bananaflux/OpenSourceSyringePump/README.md

# OpenSourceSyringePump

* Printed circuit board can be easily ordered from OSHPark: [Open Source Syringe Pump PCB](https://oshpark.com/shared_projects/VtseE2Ia)
