bananaflux/OpenSourceSyringePump/t_min and velocity formulas.pdf

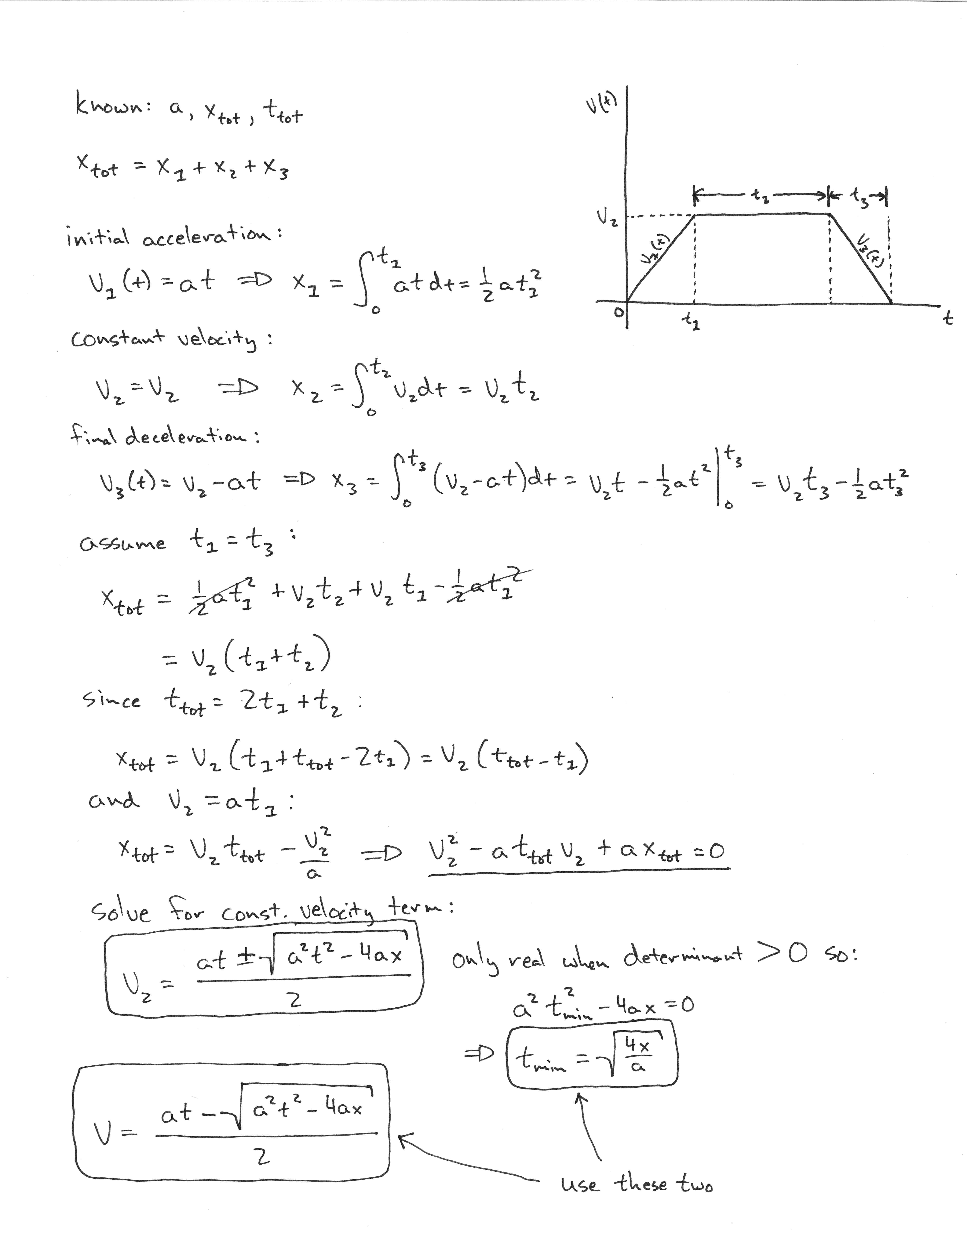
[picture p1: page 1]
