bananaflux/OpenSourceSyringePump/Syringe_Calibration_Water_Sucrose.xlsx

Sheet: 16% 60mL Syringe
Density = | 1.0472 | [g/mL]
60 mL Syringe
Steps | Mass [g] | ΔMass [g] | Vol [mL] | Vol/Step [mL/step]
0 | 0
400 | 0.7778 | 0.7778 | 0.7427425516 | 0.001856856379
800 | 1.5632 | 0.7854 | 0.75 | 0.001875
1200 | 2.3608 | 0.7976 | 0.7616501146 | 0.001904125286
1600 | 3.15 | 0.7892 | 0.7536287242 | 0.001884071811
2000 | 3.9555 | 0.8055 | 0.7691940413 | 0.001922985103
2400 | 4.74 | 0.7845 | 0.7491405653 | 0.001872851413
2800 | 5.551 | 0.811 | 0.7744461421 | 0.001936115355
3200 | 6.3425 | 0.7915 | 0.7558250573 | 0.001889562643
3600 | 7.119 | 0.7765 | 0.7415011459 | 0.001853752865
4000 | 7.9112 | 0.7922 | 0.7564935065 | 0.001891233766
4400 | 8.75 | 0.8388 | 0.8009931245 | 0.002002482811
4800 | 9.5191 | 0.7691 | 0.734434683 | 0.001836086707
5200 | 10.379 | 0.8599 | 0.8211420932 | 0.002052855233
5600 | 11.1247 | 0.7457 | 0.7120893812 | 0.001780223453
6000 | 11.96 | 0.8353 | 0.7976508785 | 0.001994127196
6400 | 12.7244 | 0.7644 | 0.7299465241 | 0.00182486631
6800 | 13.54 | 0.8156 | 0.7788388083 | 0.001947097021
7200 | 14.283 | 0.743 | 0.7095110772 | 0.001773777693
7600 | 15.045 | 0.762 | 0.7276546982 | 0.001819136746
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
