bananaflux/OpenSourceSyringePump/SyringeCalibrationExample.xlsx

Sheet: 30mL Syringe
Density = | 0.995868 | [g/mL]
30mL Syringe
Steps | Mass [g] | ΔMass [g] | Vol [mL] | Vol/Step [mL/step]
0 | 0
500 | 0.5925 | 0.5925 | 0.594958368 | 0.001189916736
1000 | 1.2101 | 0.6176 | 0.6201625115 | 0.001240325023
1500 | 1.8335 | 0.6234 | 0.6259865765 | 0.001251973153
2000 | 2.4469 | 0.6134 | 0.6159450851 | 0.00123189017
2500 | 3.0622 | 0.6153 | 0.6178529685 | 0.001235705937
3000 | 3.685 | 0.6228 | 0.625384087 | 0.001250768174
3500 | 4.2961 | 0.6111 | 0.6136355421 | 0.001227271084
4000 | 4.9138 | 0.6177 | 0.6202629264 | 0.001240525853
4500 | 5.5353 | 0.6215 | 0.6240786932 | 0.001248157386
5000 | 6.1469 | 0.6116 | 0.6141376166 | 0.001228275233
5500 | 6.7624 | 0.6155 | 0.6180537983 | 0.001236107597
6000 | 7.384 | 0.6216 | 0.6241791081 | 0.001248358216
6500 | 7.9928 | 0.6088 | 0.611325999 | 0.001222651998
7000 | 8.6107 | 0.6179 | 0.6204637562 | 0.001240927512
7500 | 9.2296 | 0.6189 | 0.6214679054 | 0.001242935811
8000 | 9.8421 | 0.6125 | 0.6150413509 | 0.001230082702
8500 | 10.4576 | 0.6155 | 0.6180537983 | 0.001236107597
9000 | 11.0804 | 0.6228 | 0.625384087 | 0.001250768174
9500 | 11.6888 | 0.6084 | 0.6109243394 | 0.001221848679
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
