bananaflux/OpenSourceSyringePump/Hardware/OpenSourceSyringePumpPCB.pdf

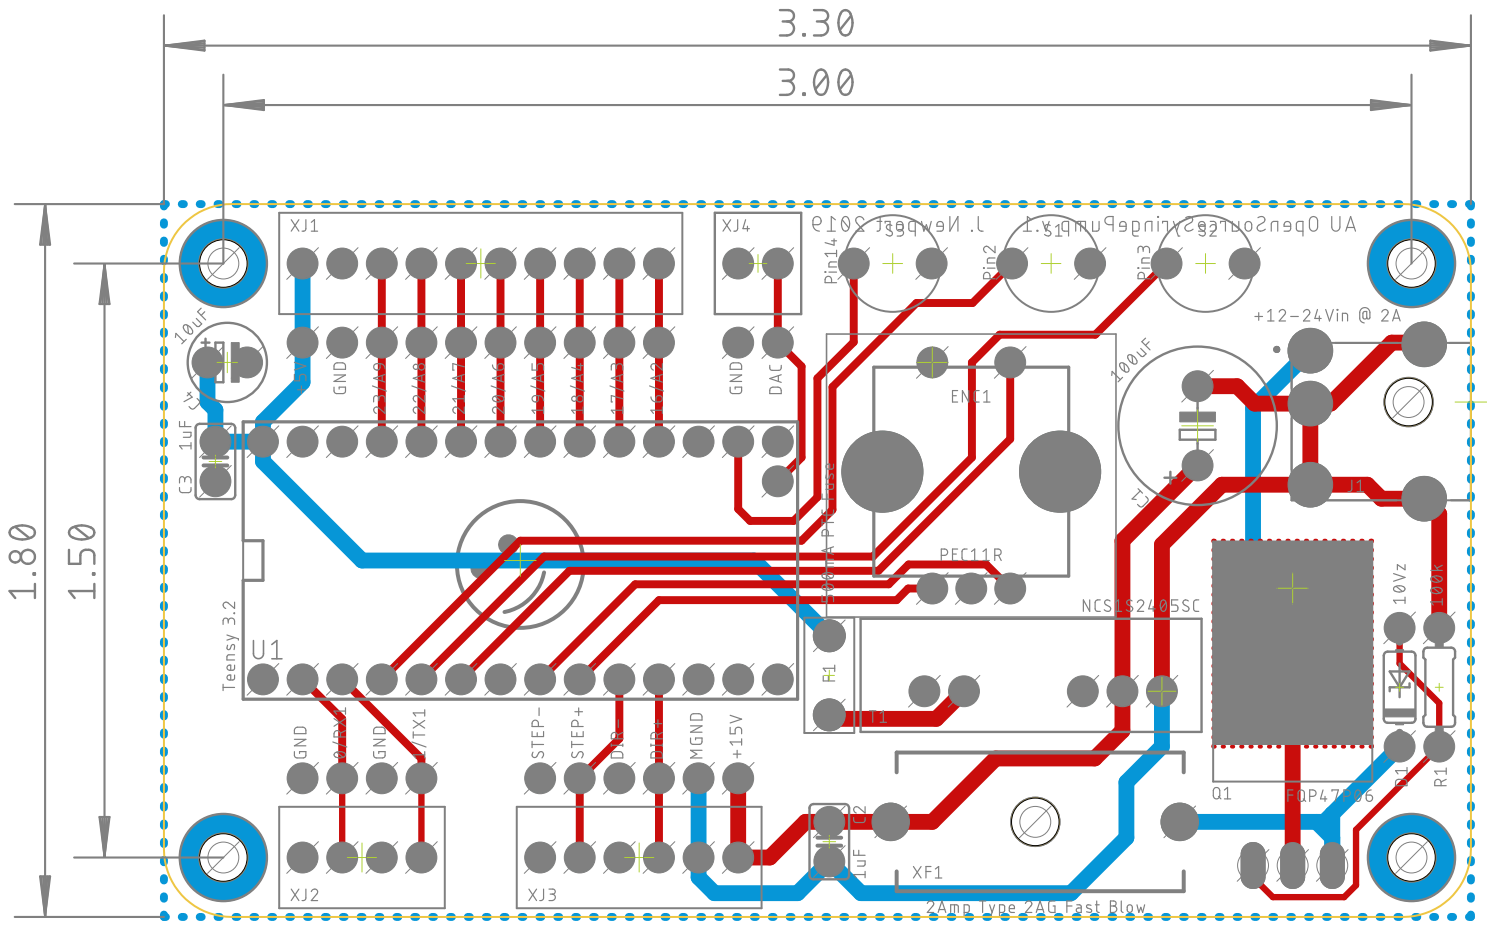
[picture p14: page 1]
