bananaflux/OpenSourceSyringePump/Hardware/OpenSourceSyringePumpSchematic.pdf

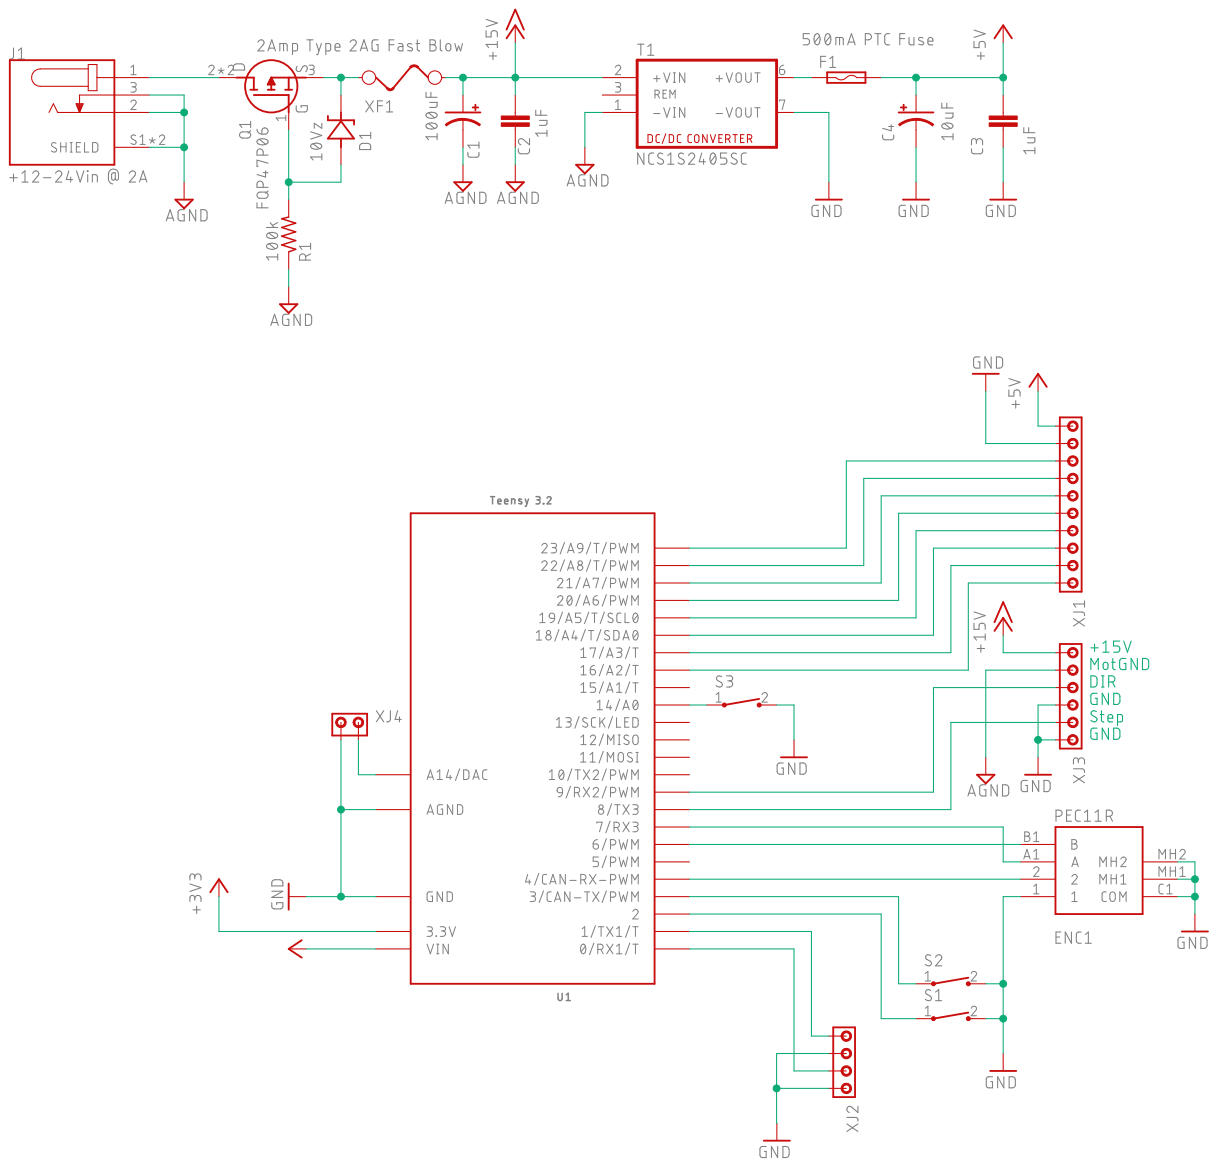
[picture p15: page 1]
