bananaflux/OpenSourceSyringePump/Hardware/OpenSourceSyringePump.brd

## EAGLE design Hardware/OpenSourceSyringePump.brd (2019-06-10)

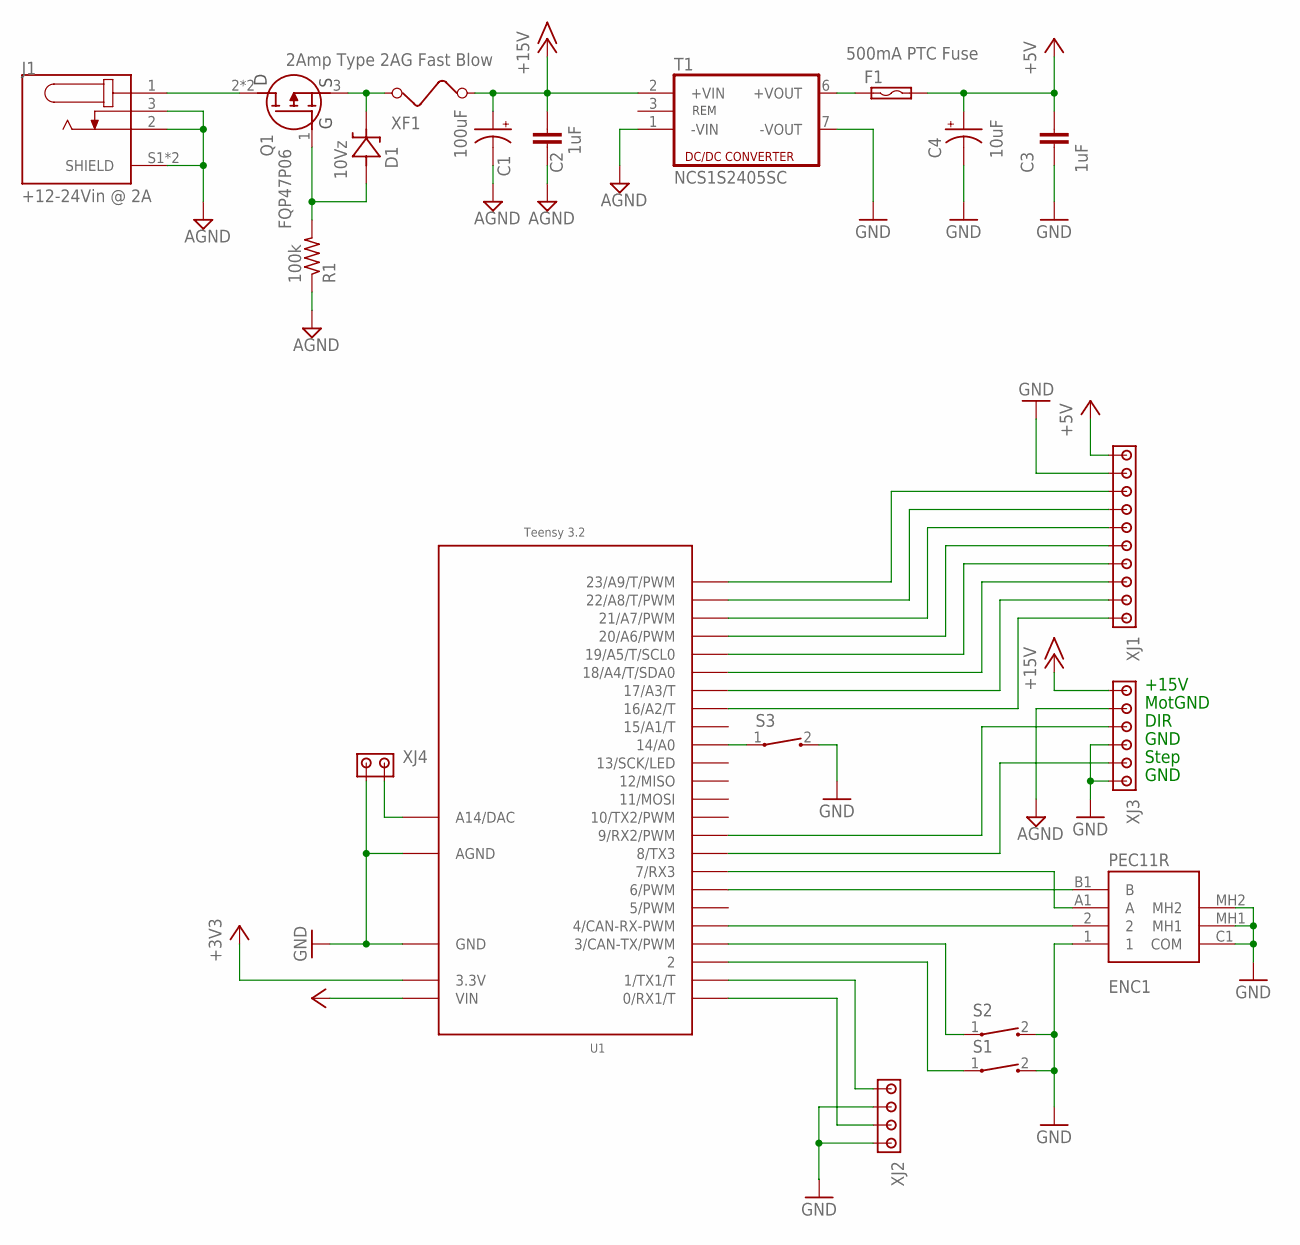
[picture p16: schematic OpenSourceSyringePump.sch]

Parts:
C1: 100uF; EEUFR1H101
C2, C3: 1uF; K105Z20Y5VF5TL2
C4: 10uF; TAP106K025SCS
D1: 10Vz; BZX79C10
ENC1: PEC11R; PEC11R4220FS0024
F1: 500mA PTC Fuse; BOURNS-MF-R025
J1: +12-24Vin @ 2A; CUI_PJ-079AH
Q1: FQP47P06
R1: 100k; 0204/7
S1, S2, S3: ALPS-SKRGAFD010
T1: NCS1S2405SC; MURATA-NCS1S2405SC
U1: Teensy 3.2; TEENSY_3.0-3.2&LC_OUTER_ROW
XF1: 2Amp Type 2AG Fast Blow; LITTLEFUSE-02540101Z
XJ1: TE-1-282834-0-DOUBLE
XJ2: TE-282834-4-DOUBLE
XJ3: TE-282834-6-DOUBLE
XJ4: TE-282834-2-DOUBLE

Connections:
+3V3: U1.3.3V
+5V: C3.1, C4.+, F1.2, U1.VIN, XJ1.1, XJ1.P$1 (1)
+15V: C1.+, C2.1, T1.2 (+VIN), XF1.1, XJ3.1, XJ3.P$1 (1)
GND: C3.2, C4.-, ENC1.1, ENC1.C1 (COM), ENC1.MH1, ENC1.MH2, S1.2, S2.2, S3.2, T1.7 (-VOUT), U1.AGND, U1.GND, XJ1.2, XJ1.P$2 (2), XJ2.2, XJ2.4, XJ2.P$2 (2), XJ2.P$4 (4), XJ3.4, XJ3.6, XJ3.P$4 (4), XJ3.P$6 (6), XJ4.1, XJ4.P$1 (1)
MGND: C1.-, C2.2, J1.2, J1.3, J1.S1 (SHIELD), J1.S2 (SHIELD), R1.1, T1.1 (-VIN), XJ3.2, XJ3.P$2 (2)
unnamed: J1.1, Q1.2 (D), Q1.MH (D)
unnamed: D1.A, Q1.1 (G), R1.2
unnamed: F1.1, T1.6 (+VOUT)
unnamed: D1.C, Q1.3 (S), XF1.2
unnamed: ENC1.B1 (B), U1.6 (6/PWM)
unnamed: ENC1.A1 (A), U1.7 (7/RX3)
unnamed: U1.0 (0/RX1/T), XJ2.3, XJ2.P$3 (3)
unnamed: U1.1 (1/TX1/T), XJ2.1, XJ2.P$1 (1)
unnamed: S2.1, U1.3 (3/CAN-TX/PWM)
unnamed: ENC1.2, U1.4 (4/CAN-RX-PWM)
unnamed: S3.1, U1.14/A0
unnamed: U1.8 (8/TX3), XJ3.5, XJ3.P$5 (5)
unnamed: U1.9 (9/RX2/PWM), XJ3.3, XJ3.P$3 (3)
unnamed: U1.16/A2 (16/A2/T), XJ1.10, XJ1.P$10 (10)
unnamed: U1.17/A3 (17/A3/T), XJ1.9, XJ1.P$9 (9)
unnamed: U1.18/A4 (18/A4/T/SDA0), XJ1.8, XJ1.P$8 (8)
unnamed: U1.19/A5 (19/A5/T/SCL0), XJ1.7, XJ1.P$7 (7)
unnamed: U1.20/A6 (20/A6/PWM), XJ1.6, XJ1.P$6 (6)
unnamed: U1.21/A7 (21/A7/PWM), XJ1.5, XJ1.P$5 (5)
unnamed: U1.22/A8 (22/A8/T/PWM), XJ1.4, XJ1.P$4 (4)
unnamed: U1.23/A9 (23/A9/T/PWM), XJ1.3, XJ1.P$3 (3)
unnamed: S1.1, U1.2
unnamed: U1.RESET/DAC (A14/DAC), XJ4.2, XJ4.P$2 (2)

Notes on the sheet:
+15V
MotGND
GND
Step
DIR

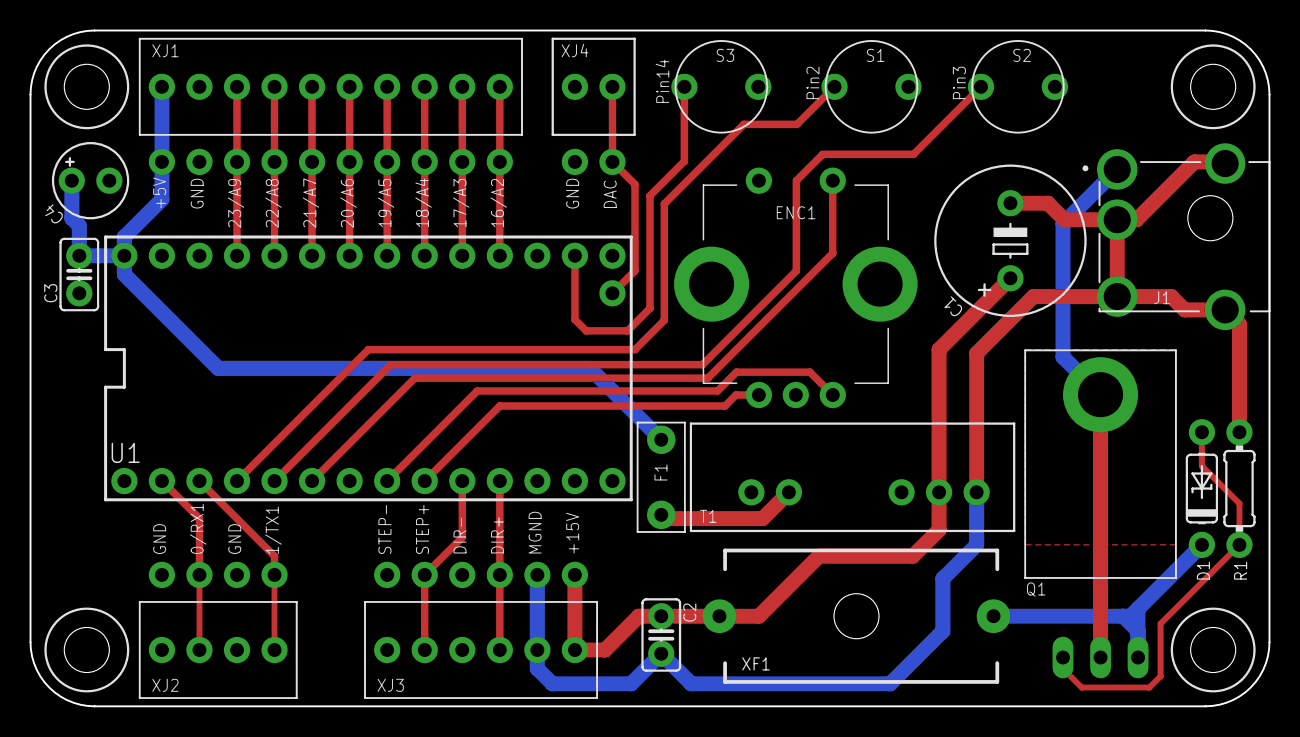
[picture p17: board OpenSourceSyringePump.brd from above]

Board: 2 copper layers, 83.8 x 45.7 mm, 20 parts (0 on the bottom side), 27 nets.
